y23tanaka/LambdaShifter2.0/hardware/esp32-2.png

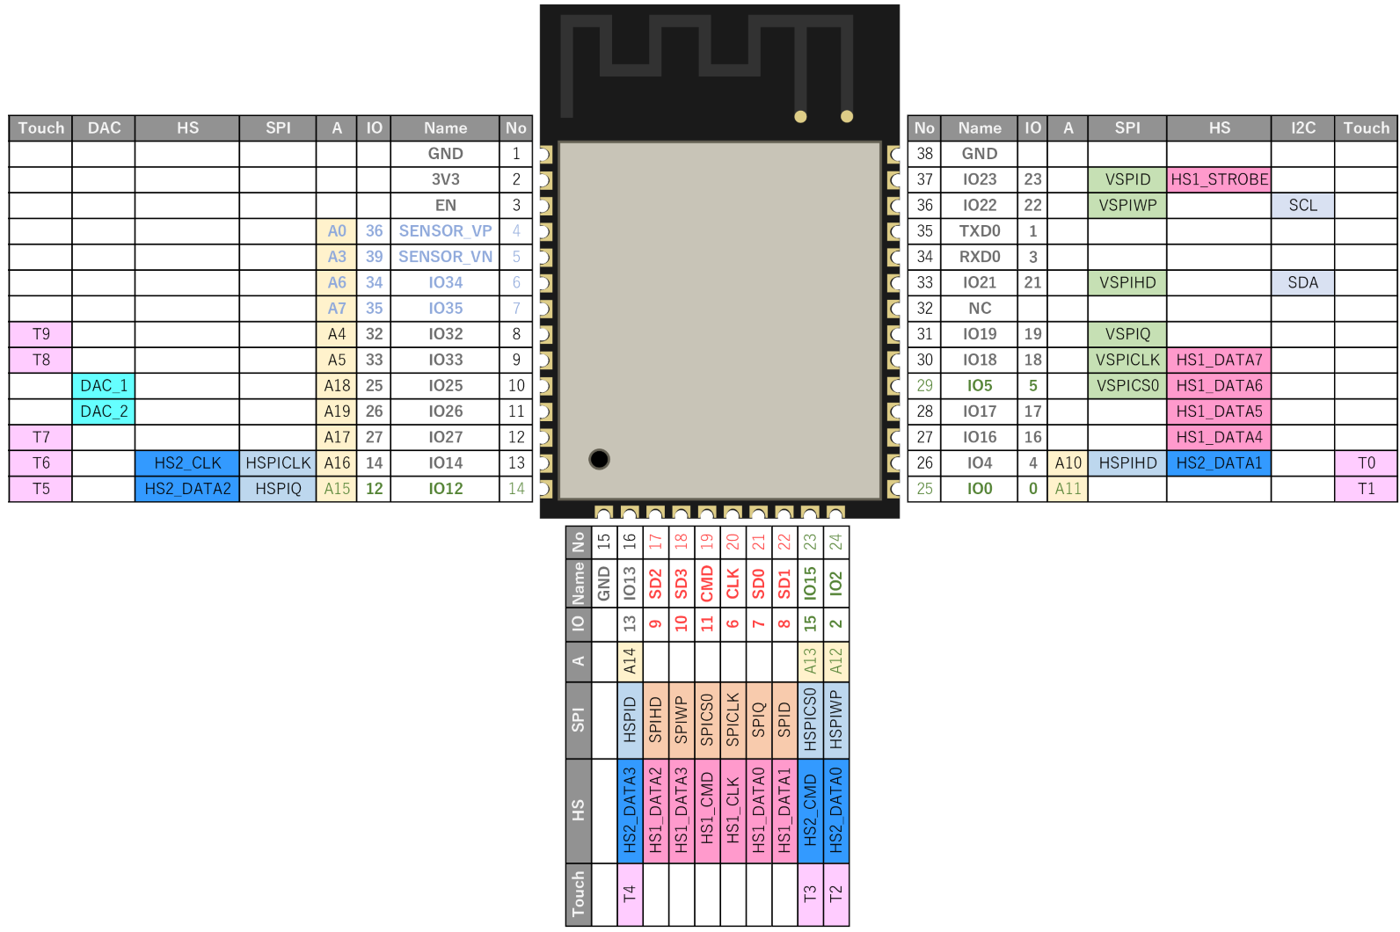
hardware/esp32-2.png
