y23tanaka/LambdaShifter2.0/hardware/LamdaShifter_2_0SMT_BOM.xlsx

LambdaShifter2.0 BOM SMD
Item # | *Ref Des | *Qty | Manufacturer | *Mfg Part # | Description / Value | *Package | Type | Your Instructions / Notes
1 | IC1 | 1 | Espressif Systems | ESP-WROOM-32 |  | QFN6×6 | SMD
2 | Q1 | 1 | mrmraket | DCDC Converter3.3v |  | LM78xx | thru-hole | https://ja.aliexpress.com/item/4000714041437.html
3 | TH1 | 1 | Murata industory co.ltd. | PRG21BC2R2MM1RA | PTC Thermistors for Inrush Current Protection | 2012 | SMD | https://akizukidenshi.com/catalog/g/gP-11868/
4 | VR1 | 1 | Yangzhou Yangjie Electronic Technology Co, Ltd. | SMAJ45A | Surge absorber (Varistor) 47V | DO-214AC | SMD | https://akizukidenshi.com/download/ds/yangjie/SMAJ.pdf
5 | Q2,Q3 | 2 | ROHM | DTC114EKAT146 | Built-in Register Transistor | SOD-123FL | SMD
6 | D1,D2,D3 | 3 | PANJIT INTERNATIONAL INC. | GS1010FL |  | SOT-346 | SMD
7 | C1,C2 | 2 |  |  | 10μF | 3216 | SMD
8 | C3 | 1 |  |  | 0.1μF | 3216 | SMD
9 | R1 | 1 |  |  | 10KΩ | 3216 | SMD
10
11
12
13
14
Below are the components needed to connect the device to the car body.
Item # | *Ref Des | *Qty | Manufacturer | *Mfg Part # | Description / Value | *Package | Type | Your Instructions / Notes
1 |  | 1m |  | 22swg wiring cable | Black/Red/White/Yellow/Blue/Green Blue and Green are for map switching options.
2 |  | 1 |  | Fuse Box/Fuse 1A | Fuse Box/Fuse 1A
3 |  | 10 |  | Bullet terminal male | Spare parts included.
4 |  | 10 |  | Bullet terminal female | Spare parts included.
5 |  | 2 |  | Electro-tap | Power supply and O2 sensor gray connection.
6 |  | 1 |  | C-type terminals | For GND connection.
7 |  | 2 |  | Flat terminals 250 type | For map switching option
8
9
10
