y23tanaka/LambdaShifter2.0/test/Template_Lambda_Shifter2_0_Inspection_Sheet_LS20-AP0000_en-US.docx

number | category | Test Contents | result | remarks
1 | SSID | SSID on the surface of the sticker in the results | LS20-AP0000
2 | internal state | Check the condition of the substrate before caulking. The copper wire of the cable is not in contact with other cables or components. Shrink tubing must be in close contact with the cable | ✓ | Paste a photo of the base inside the device on the next page.
3 | power (button on TV, etc.) | Connect the device to a 9v or 12v power source ・Can the device connect to WiFi as indicated on the sticker? Is the menu displayed correctly? | ✓
4 | Input 1 | Input 0.2v and 0.8v voltage between white cable #1 and GND (black). . Is there any difference from the voltage of gray bar #1 on the graph? | ✓
5 | Output 1 | Measure the voltage between gray cable #1 and GND (black). Is there any difference from the display of gray bar #1 on the graph? Set "disable" in the "Shift Voltage" menu and see if the output is around 450mv. When 0.95v or more is input, is 0.95v or less output? When 0.08v or less is input, does it output 0.08v or more? | ✓
6 | Input 2 | Input 0.2v and 0.8v voltage between white cable #2 and GND (black). Is there any difference from the voltage displayed on the graph? | ✓
7 | Output 2 | Tester measures voltage between gray cable #1 and GND (black). Is there any difference from the display of gray bar #1 on the graph? Set "disable" to "Shift Voltage" in the menu, and check if the output voltage is around 450mv. If the output voltage is around 450 mv, set the Shift Voltage in the menu to disable. When 0.95v or more is input, is 0.95v or less output? When 0.08v or less is input, does it output 0.08v or more? | ✓
8 | Map 1 | Set the menu map to 1 and measure the resistance; connect the red of the tester to GND and the black of the tester to each cable. No continuity between the brown cable and GND No continuity between the green cable and GND | ✓
9 | Map 2 | Set the menu map to 1 and measure the resistance; connect the red of the tester to GND (black) and the black of the tester to each cable. The resistance between the brown cable and GND must be 0Ω. | ✓
10 | Map 3 | Set the menu map to 1 and measure the resistance; connect the red of the tester to GND (black) and the black of the tester to each cable. The resistance between the brown cable and the GND must be 0Ω. | ✓
11 | appearance | No damage to the exterior ・No loss of seals ・No caulking protruding from the surface | ✓ | Paste a photo of the device's exterior on the next page
12 | identifier | The name of the confirming party is included in the results. | Yosuke Tanaka
13 | Confirmation Date | Date of confirmation is noted in the results | 2022/10/20

Lambda Shifter2.0 OTA Inspection Results Chart

Lambda Shifter2.0 OTA Internal photo


Lambda Shifter2.0 OTA Exterior view
