y23tanaka/LambdaShifter2.0/test/Template_Lambda_Shifter2_0_Inspection_Sheet_LS20-AP0000_JP.docx

番号 | カテゴリ | テスト内容 | 結果 | 備考
1 | SSID | シール表面のSSIDを結果に記載 | LS20-AP0000
2 | 内部状態 | コーキング前に基盤の状態を確認する。 ・はんだ付けの状態が正しいこと ・フラックス等で汚れていないこと ・ケーブルの銅線が他のケーブルや部品に接触していないこと ・収縮チューブはケーブルに密着していること | ✓ | 次ページデバイス内部の基盤写真を貼り付け
3 | 電源 | デバイスを9v、ないしは12vの電源に接続 ・シールに記載したWiFiに接続できるか。 ・メニューは正しく表示されるか。 | ✓
4 | 入力1 | 白色ケーブル#1と GND(黒)間に、0.2v、0.8vの電圧を入力。 ・グラフの灰色バー#1の電圧との差異がないか。 | ✓
5 | 出力1 | 灰色ケーブル#1とGND(黒)間の電圧を測定。 ・グラフの灰色バー#1の表示と差異がないか。 ・メニューのShift Voltageでdisableをセットし、450mv付近が出力されるか。 ・0.95v以上を入力した際に、0.95v以下が出力されるか。 ・0.10v以下が入力された際に、0.10v以上が出力されるか | ✓
6 | 入力2 | 白色ケーブル#2とGND(黒)間に、0.2v、0.8vの電圧を入力。 ・グラフ表示の電圧との差異がないか。 | ✓
7 | 出力2 | 灰色ケーブル#1とGND(黒)間の電圧をテスター測定。 ・グラフの灰色バー#1の表示と差異がないか。 ・メニューのShift Voltageでdisableをセットし、450mv付近が出力されるか。・ ・0.95v以上を入力した際に、0.95v以下が出力されるか。 ・0.10v以下が入力された際に、0.10v以上が出力されるか | ✓
8 | マップ1 | メニューのマップを1とし、抵抗を測定する。GNDにテスターの赤、各ケーブルにテスターの黒を接続すること。 ・茶色のケーブルとGND間に導通がないこと ・緑色のケーブルとGND間に導通がないこと | ✓
9 | マップ2 | メニューのマップを1とし、抵抗を測定する。GND(黒)にテスターの赤、各ケーブルにテスターの黒を接続すること。 ・茶色のケーブルとGND間の抵抗が0Ωであること。 | ✓
10 | マップ3 | メニューのマップを1とし、抵抗を測定する。GND(黒)にテスターの赤、各ケーブルにテスターの黒を接続すること。 ・茶色のケーブルとGND間の抵抗が0Ωであること。 | ✓
11 | 外観 | ・外観に傷等がないこと ・シールに敗れ等がないこと ・コーキングが表面にはみ出ていないこと | ✓ | 次ページにデバイスの外観写真を貼り付け
12 | 確認者 | 確認者の名前を結果に記載。 | 田中 洋介
13 | 確認日 | 確認日を結果に記載 | 2022/10/20

Lambda Shifter2.0 OTA 検品結果表

Lambda Shifter2.0 OTA 内部写真


Lambda Shifter2.0 OTA 外観写真
