y23tanaka/LambdaShifter2.0/test/calibration.xlsx

Sheet: input
インプット キャリブレーション結果
シリアル | 傾き | オフセット | 200mV付近 |  |  | 800mV付近
 |  |  | 実測電圧 | LS電圧 | 誤差 | 実測電圧 | LS電圧 | 誤差
LS20-AP0021 | 3090 | 0.095 | 204.7 | 206 | 1.3 | 808 | 809 | -1
LS20-AP0028 | 3090 | 0.095 | 194 | 208 | 14 | 805 | 875 | -70
LS20-AP0028 | 3190 | 0.105 | 202 | 223 | 21 | 804 | 860 | 56
LS20-AP0028 | 3290 | 0.085 | 200 | 199 | -1 | 782 | 794 | 12
LS20-AP0028 | 3320 | 0.09 | 205 | 206 | 1 | 782 | 793 | 11
LS20-AP0028 | 3330 | 0.09 | 205 | 205 | 0 | 805 | 814 | 9
LS20-AP0028 | 3350 | 0.09 | 200 | 200 | 0 | 804 | 808 | 4
LS20-AP0028 | 3365 | 0.09 | 199 | 200 | 1 | 797 | 798 | 1
LS20-AP0029 | 3365 | 0.09 | 212 | 219 | 7 | 794 | 823 | 29
LS20-AP0029 | 3415 | 0.1 | 197 | 189 | -8 | 808 | 760 | -48
LS20-AP0029 | 3380 | 0.1 | 197 | 191 | -6 | 791 | 748 | -43
LS20-AP0029 | 3340 | 0.1 | 203 | 199 | -4 | 791 | 760 | -31
LS20-AP0029 | 3220 | 0.1 | 202 | 202 | 0 | 803 | 796 | -7
LS20-AP0029 | 3190 | 0.1 | 210 | 212 | 2 | 802 | 802 | 0
LS20-AP0029 | 3190 | 0.11 | 188 | 202 | 14 | 802 | 814 | 12
LS20-AP0029 | 3190 | 0.12 | 188 | 211 | 23 | 803 | 826 | 23
LS20-AP0029 | 3190 | 0.13 | 192 | 223 | 31 | 802 | 836 | 34
LS20-AP0029 | 3190 | 0.15 | 192 | 244 | 52 | 800 | 850 | 50
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
