y23tanaka/LambdaShifter2.0/(list of files, drawings)

Other design files:
hardware/Lambda_shiftert2.0SMT.pcb
hardware/Lambda_shiftter2.0TH.pcb
hardware/old/narrowband_shift2.0.pcb
hardware/old/narrowband_shift2.1.pcb
hardware/old/narrowband_shift2.2.pcb
hardware/old/narrowband_shift2.3.pcb
hardware/old/narrowband_shift2.4.pcb
hardware/old/narrowband_shift2.5.pcb
hardware/old/narrowband_shift2.7.pcb
hardware/old/~narrowband_shift2.3.pcb
hardware/old/~narrowband_shift2.4.pcb
hardware/old/~~narrowband_shift2.5.pcb
hardware/old/~~~narrowband_shift2.4.pcb
