y23tanaka/LambdaShifter2.0/(commit log)

2022-10-11 refactor : env change to PlatformIO
    [ls-oat_log.csv, narrowband_shift2.0.pcb, narrowband_shift2.1.pcb, narrowband_shift2.2.pcb, narrowband_shift2.3.pcb, narrowband_shift2.4.pcb, narrowband_shift2.5.pcb, narrowband_shift2.6.pcb]
2022-10-12 Create BOM
    [LamdaShifter_2_0.xlsx]
2022-10-12 UPDATE BOM & PCB file
    [LamdaShifter_2_0_BOM.xlsx, narrowband_shift2.6.pcb, ~narrowband_shift2.6.pcb]
2022-10-12 Add device picture
2022-10-18 Add PCB SMD version
    [Lambda_shiftert2.0SMT.pcb, Lambda_shiftter2.0TH.pcb, ~Lambda_shiftert2.0SMT.pcb]
2022-10-18 Update PCB SMD version
    [Lambda_shiftert2.0SMT.pcb]
2022-10-19 Update PCB SMD version, and add BOM file
    [Lambda_shiftert2.0SMT.pcb, LamdaShifter_2_0SMT_BOM - Copy.xlsx, LamdaShifter_2_0TH_BOM.xlsx, ~Lambda_shiftert2.0SMT.pcb]
2022-10-19 Add draft sckech
    [Lambda_shiftert2.0.sch]
2022-10-23 Update BOM,PCB for correct reference name
    [Lambda_shiftert2.0SMT.pcb, LamdaShifter_2_0SMT_BOM - Copy.xlsx]
2022-10-24 Update sch file
    [Lambda_shiftert2.0.sch]
2022-11-01 Update Inspection sheet
    [Lambda_shiftert2.0.sch, Lambda_shiftert2.0SMT.pcb, ~Lambda_shiftert2.0SMT.pcb, ~~Lambda_shiftert2.0SMT.pcb]
2022-11-08 Update .pcb, BOM file
    [Lambda_shiftert2.0SMT.pcb, LamdaShifter_2_0SMT_BOM - Copy.xlsx, LamdaShifter_2_0SMT_BOM.xlsx]
2022-11-14 Update BOM files.
    [LamdaShifter_2_0SMT_BOM.xlsx, LamdaShifter_2_0TH_BOM.xlsx]
2022-11-21 Fix graph bug for iPhone
    [Lambda_shiftert2.0SMT.pcb]
2022-12-05 Update Manual
    [LamdaShifter_20SMT_BOM_pcbgogo.xlsx]
2022-12-17 Update sensor input logic.etc
    [calibration.xlsx, ~Lambda_shiftert2.0SMT.pcb]
2022-12-22 Update manuals and Program
    [Lambda_shiftert2.0SMT.pcb, calibration.xlsx, ~Lambda_shiftert2.0SMT.pcb]
